Epeteys/Cave_Radio_PDB/README.md

\# Cave\_Radio\_PDB

Cave Radio Power Distribution Board. Consists of a battery input to USB-C/9V-jack outputs, as well as data passthrough from the USB-C to a USB-A connector.
