Epeteys/Cave_Radio_PDB/BOM/Cave_Radio_PDB.ods

Reference | Qty | Value | PN | DNP | Exclude from BOM | Exclude from Board | Footprint
C1,C2,C3,C13,C15,C16,C17 | 7 | 0.1uF | CC0402KRX5R9BB104 |  |  |  | Cave_Radio_PDB:C_0402_1005Metric
C4,C6,C7,C11,C12 | 5 | 10uF | GRM188R61A106ME69D |  |  |  | Cave_Radio_PDB:R_0603_1608Metric
C9,C10 | 2 | 1nF | CC0402KRX7R9BB102 |  |  |  | Cave_Radio_PDB:C_0402_1005Metric
C14,C18 | 2 | 33pF | CC0402FRNPO9BN330 |  |  |  | Cave_Radio_PDB:C_0402_1005Metric
C19,C20,C21,C22,C23,C24,C25,C26,C27,C28,C29,C30 | 12 | 22uF | C3225X5R1C226M250AA |  |  |  | Cave_Radio_PDB:CAP_C3225X5R1C226M250AA
J9 | 1 | USB4110GFA | USB4110GFA |  |  |  | Cave_Radio_PDB:GCT_USB4110GFA
L1,L2 | 2 | 6.8uH | SRP5050FA-6R8M |  |  |  | Cave_Radio_PDB:IND_SPR5050_BRN-M
R1,R2,R3,R4,R14,R27 | 6 | 10k | RC0402FR-0710KL |  |  |  | Cave_Radio_PDB:R_0402_1005Metric
R5,R6 | 2 | 2.2k | RC0402FR-072K2L |  |  |  | Cave_Radio_PDB:R_0402_1005Metric
R7,R8,R11,R13,R24,R25,R26 | 7 | 0 | RC0402JR-070RL |  |  |  | Cave_Radio_PDB:R_0402_1005Metric
R15,R20 | 2 | 100k | RC0402FR-07100KL |  |  |  | Cave_Radio_PDB:R_0402_1005Metric
R16 | 1 | 19.1k | RC0402FR-0719K1L |  |  |  | Cave_Radio_PDB:R_0402_1005Metric
R17,R22 | 2 | 1k | RC0402FR-071KL |  |  |  | Cave_Radio_PDB:R_0402_1005Metric
R18 | 1 | 39.2k | RC0402FR-0739K2L |  |  |  | Cave_Radio_PDB:R_0402_1005Metric
R19 | 1 | 25.5k | RC0402FR-0725K5L |  |  |  | Cave_Radio_PDB:R_0402_1005Metric
R21 | 1 | 9.76k | RC0402FR-079K76L |  |  |  | Cave_Radio_PDB:R_0402_1005Metric
U1 | 1 | TPS25751D | TPS25751DREFR |  |  |  | Cave_Radio_PDB:Texas_REF0038A_WQFN-38-2EP_6x4mm_P0.4
U2 | 1 | CAT24C256 | CAT24C256HU4IGT3 |  |  |  | Cave_Radio_PDB:UDFN8_2X3_ONS
U3 | 1 | TLV75533PDRV | TLV75533PDRV |  |  |  | Cave_Radio_PDB:WSON-6-1EP_2x2mm_P0.65mm_EP1x1.6mm_ThermalVias
U4 | 1 | TVS2200DRV | TVS2200DRV |  |  |  | Cave_Radio_PDB:WSON-6-1EP_2x2mm_P0.65mm_EP1x1.6mm_ThermalVias
U5 | 1 | TPD2E2U06DRL | TPD2E2U06DRL |  |  |  | Cave_Radio_PDB:SOT-553
U6,U7 | 2 | LMR51450FNDRR | LMR51450FNDRR |  |  |  | Cave_Radio_PDB:WSON-12-1EP_3x3mm_P0.5mm_EP1.5x2.5mm_ThermalVias
