Epeteys/Cave_Radio_PDB/Cave_Radio_3D/NSR0340HT1G.STEP

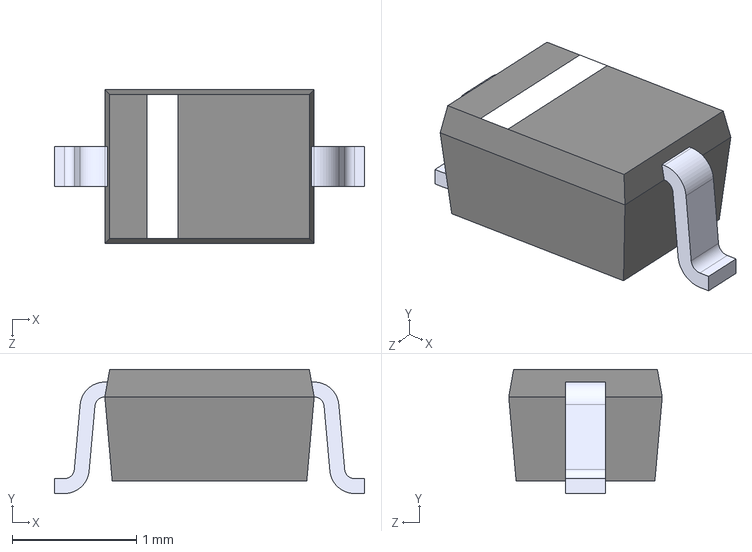
[picture p1: CAD file, 2026-04-06]
Cave_Radio_3D/NSR0340HT1G.STEP
2.50 x 1.00 x 1.24 mm
