Epeteys/Cave_Radio_PDB/Cave_Radio_3D/CAT24C256HU4IGT3--3DModel-STEP-56544.STEP

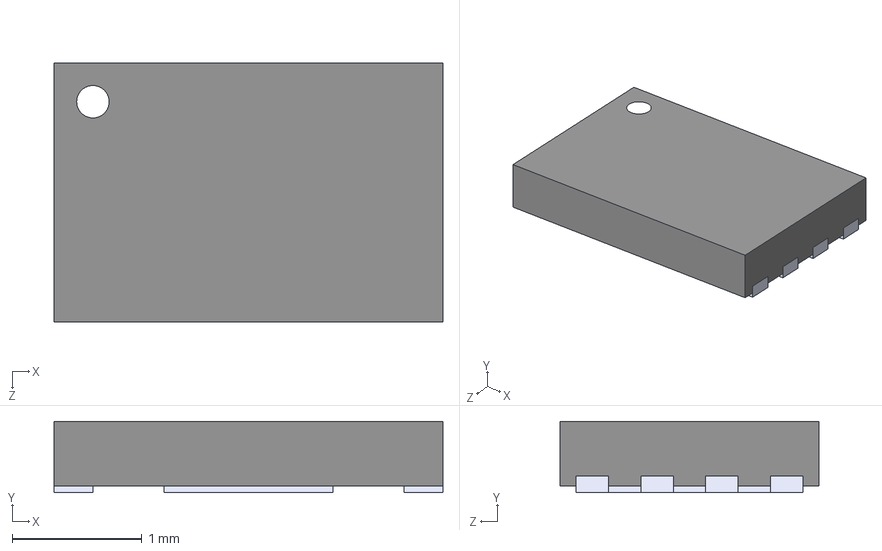
[picture p2: CAD file, 2026-04-06]
Cave_Radio_3D/CAT24C256HU4IGT3--3DModel-STEP-56544.STEP
3.00 x 0.55 x 2.00 mm
