Epeteys/Cave_Radio_PDB/Cave_Radio_3D/SRP5050FA-220M1.stp

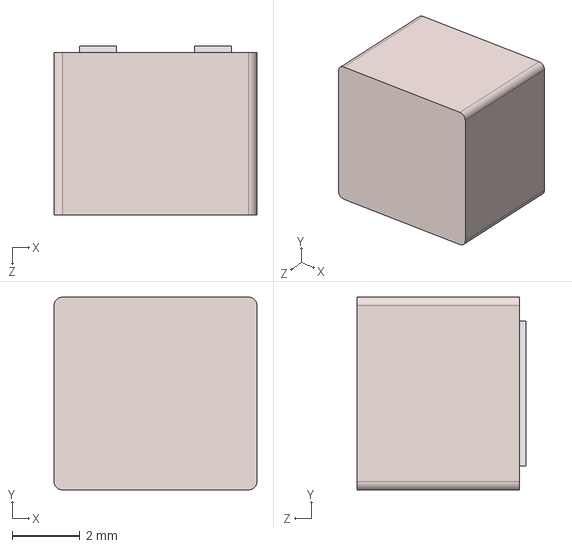
[picture p3: CAD file, 2026-04-06]
Cave_Radio_3D/SRP5050FA-220M1.stp
6.00 x 5.70 x 5.00 mm
