Epeteys/Cave_Radio_PDB/Cave_Radio_3D/LMR51450FNDRRR.STEP

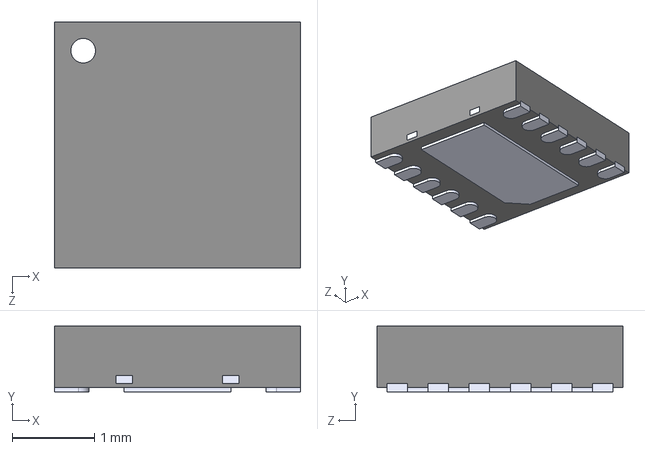
[picture p4: CAD file, 2026-04-06]
Cave_Radio_3D/LMR51450FNDRRR.STEP
3.00 x 0.8 x 3.00 mm
