Epeteys/Cave_Radio_PDB/Cave_Radio_3D/TPS25751DREFR--3DModel-STEP-56544.STEP

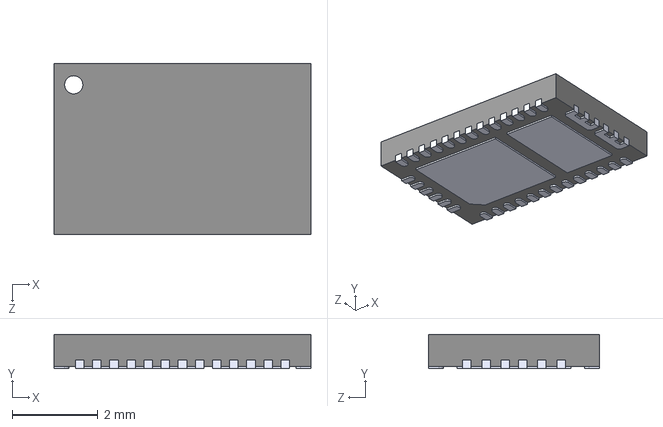
[picture p5: CAD file, 2026-04-06]
Cave_Radio_3D/TPS25751DREFR--3DModel-STEP-56544.STEP
6.00 x 0.8 x 4.00 mm
