Epeteys/Cave_Radio_PDB/Cave_Radio_3D/TPS259472LRPWR.STEP

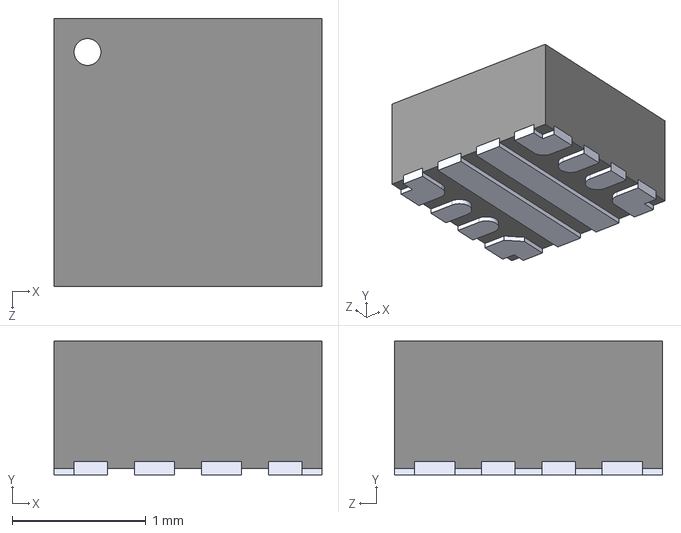
[picture p6: CAD file, 2026-04-06]
Cave_Radio_3D/TPS259472LRPWR.STEP
2.00 x 1.00 x 2.00 mm
