Epeteys/Cave_Radio_PDB/Cave_Radio_PDB.kicad_pcb

## KiCad design Cave_Radio_PDB.kicad_pcb (2026-04-13)

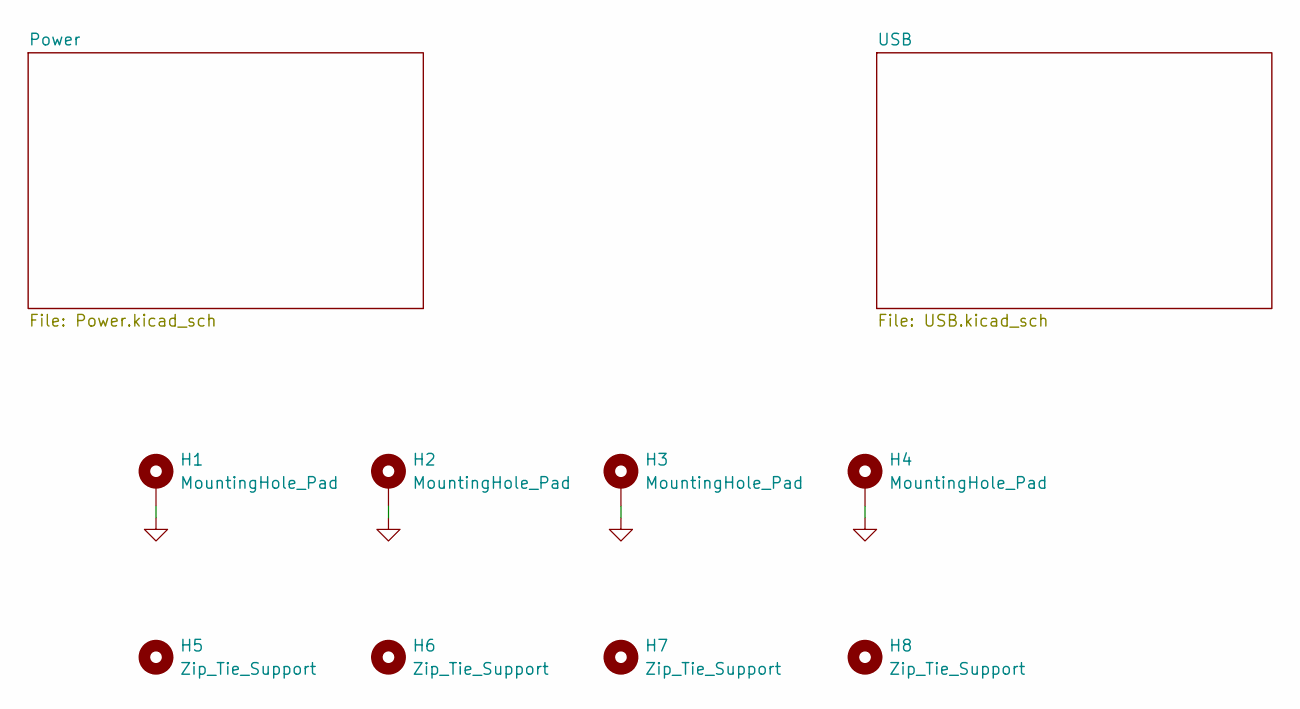
[picture p7: schematic Cave_Radio_PDB.kicad_sch, Cave Radio PDB]

Parts:
H1, H2, H3, H4: MountingHole_Pad; MountingHole_3.2mm_M3_DIN965_Pad_TopBottom
H5, H6, H7, H8: Zip_Tie_Support

Connections:
GND: H1.1, H2.1, H3.1, H4.1; also elsewhere on the board

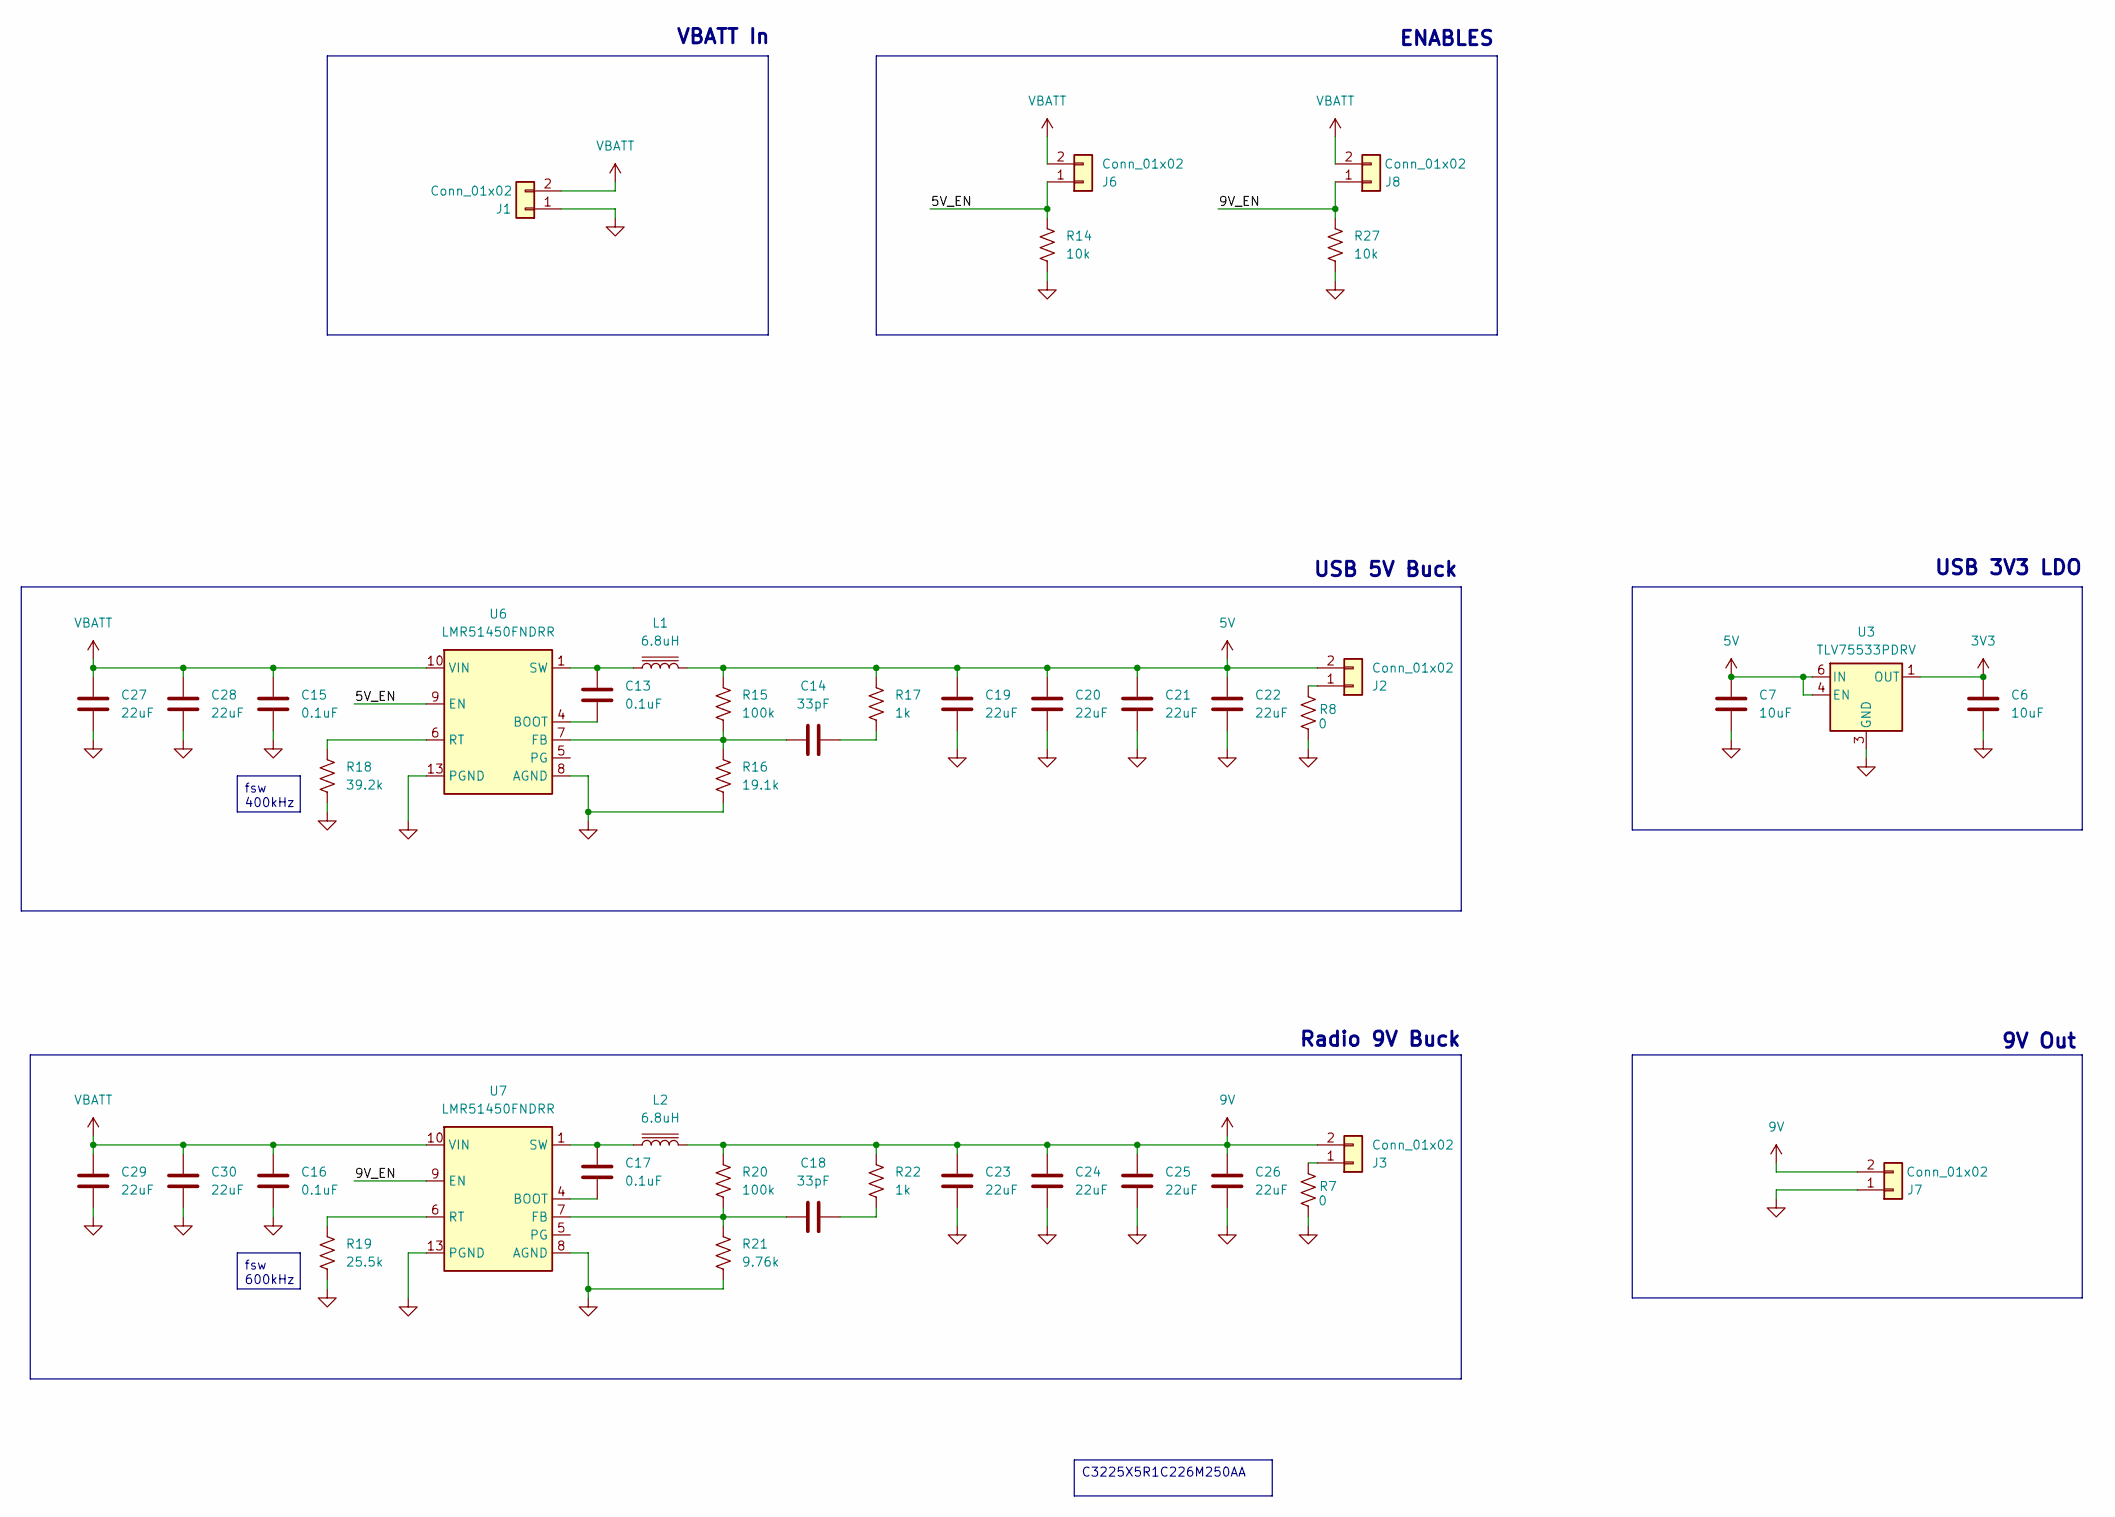
[picture p8: schematic Power.kicad_sch, Cave Radio PDB]

Parts:
C6, C7: 10uF; R_0603_1608Metric
C13, C15, C16, C17: 0.1uF; C_0402_1005Metric
C14, C18: 33pF; C_0402_1005Metric
C19, C20, C21, C22, C23, C24, C25, C26, C27, C28, C29, C30: 22uF; CAP_C3225X5R1C226M250AA
J1: Conn_01x02; CONN_102_PWR
J2, J3, J6, J7, J8: Conn_01x02; CONN_TSW-102-S_SAI
L1, L2: 6.8uH; IND_SPR5050_BRN-M
R7, R8: 0; R_0402_1005Metric
R14, R27: 10k; R_0402_1005Metric
R15, R20: 100k; R_0402_1005Metric
R16: 19.1k; R_0402_1005Metric
R17, R22: 1k; R_0402_1005Metric
R18: 39.2k; R_0402_1005Metric
R19: 25.5k; R_0402_1005Metric
R21: 9.76k; R_0402_1005Metric
U3: TLV75533PDRV; WSON-6-1EP_2x2mm_P0.65mm_EP1x1.6mm_ThermalVias
U6, U7: LMR51450FNDRR; WSON-12-1EP_3x3mm_P0.5mm_EP1.5x2.5mm_ThermalVias

Connections:
3V3: C6.1, U3.1 (OUT); also elsewhere on the board
5V: C7.1, C19.1, C20.1, C21.1, C22.1, J2.2, L1.2, R15.1, R17.1, U3.4 (EN), U3.6 (IN); also elsewhere on the board
9V: C23.1, C24.1, C25.1, C26.1, J3.2, J7.2, L2.2, R20.1, R22.1
/Power/5V_EN: J6.1, R14.1, U6.9 (EN)
/Power/9V_EN: J8.1, R27.1, U7.9 (EN)
GND: C6.2, C7.2, C15.2, C16.2, C19.2, C20.2, C21.2, C22.2, C23.2, C24.2, C25.2, C26.2, C27.2, C28.2, C29.2, C30.2, J1.1, J7.1, R7.1, R8.1, R14.2, R16.2, R18.2, R19.2, R21.2, R27.2, U3.3 (GND), U3.7 (GND), U6.8 (AGND), U6.13 (PGND), U7.8 (AGND), U7.13 (PGND); also elsewhere on the board
unnamed: C13.1, L1.1, U6.1 (SW), U6.2 (SW), U6.3 (SW)
unnamed: C14.2, R17.2
unnamed: C17.1, L2.1, U7.1 (SW), U7.2 (SW), U7.3 (SW)
unnamed: C18.2, R22.2
unnamed: J2.1, R8.2
unnamed: J3.1, R7.2
unnamed: C13.2, U6.4 (BOOT)
unnamed: C14.1, R15.2, R16.1, U6.7 (FB)
unnamed: R18.1, U6.6 (RT)
unnamed: C17.2, U7.4 (BOOT)
unnamed: C18.1, R20.2, R21.1, U7.7 (FB)
unnamed: R19.1, U7.6 (RT)
VBATT: C15.1, C16.1, C27.1, C28.1, C29.1, C30.1, J1.2, J6.2, J8.2, U6.10 (VIN), U6.11 (VIN), U6.12 (VIN), U7.10 (VIN), U7.11 (VIN), U7.12 (VIN)

Notes on the sheet:
USB 5V Buck
Radio 9V Buck
USB 3V3 LDO
ENABLES
VBATT In
9V Out
fsw 400kHz
fsw 600kHz
C3225X5R1C226M250AA

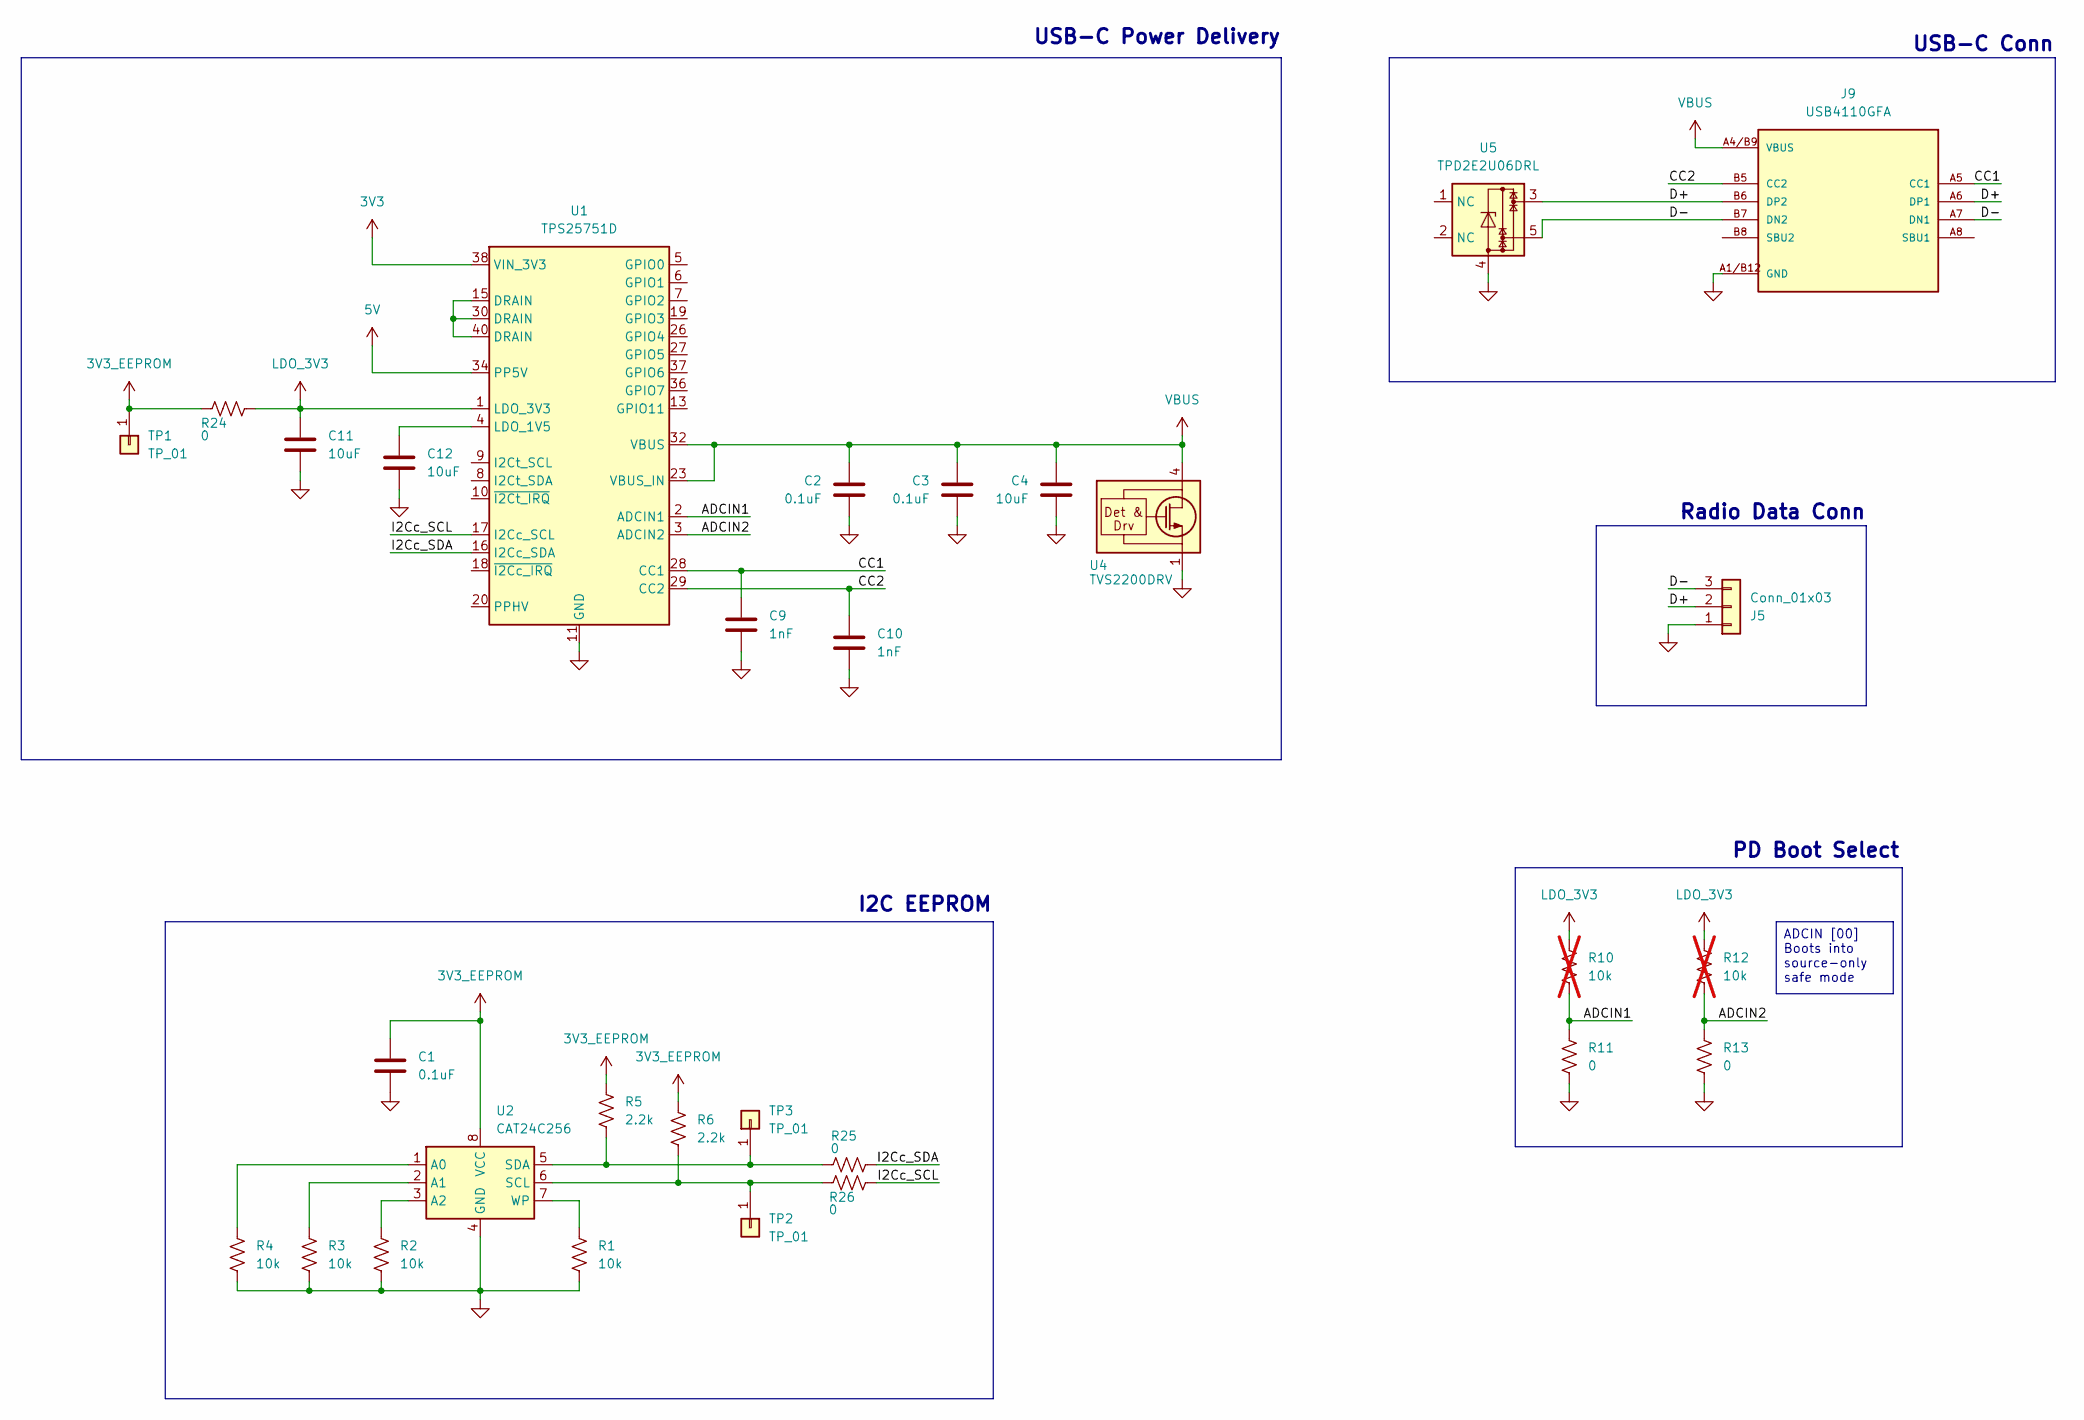
[picture p9: schematic USB.kicad_sch, Cave Radio PDB]

Parts:
C1, C2, C3: 0.1uF; C_0402_1005Metric
C4, C11, C12: 10uF; R_0603_1608Metric
C9, C10: 1nF; C_0402_1005Metric
J5: Conn_01x03; CONN_TSW-103-S_SAI
J9: USB4110GFA; GCT_USB4110GFA
R1, R2, R3, R4: 10k; R_0402_1005Metric
R5, R6: 2.2k; R_0402_1005Metric
R10, R12: 10k; R_0402_1005Metric; not fitted
R11, R13, R24, R25, R26: 0; R_0402_1005Metric
TP1, TP2, TP3: TP_01; CONN_TP
U1: TPS25751D; Texas_REF0038A_WQFN-38-2EP_6x4mm_P0.4
U2: CAT24C256; UDFN8_2X3_ONS
U4: TVS2200DRV; WSON-6-1EP_2x2mm_P0.65mm_EP1x1.6mm_ThermalVias
U5: TPD2E2U06DRL; SOT-553

Connections:
3V3: U1.38 (VIN_3V3); also elsewhere on the board
3V3_EEPROM: C1.1, R5.1, R6.1, R24.1, TP1.1, U2.8 (VCC)
5V: U1.34 (PP5V); also elsewhere on the board
/USB/ADCIN1: R10.2, R11.1, U1.2 (ADCIN1)
/USB/ADCIN2: R12.2, R13.1, U1.3 (ADCIN2)
/USB/CC1: C9.1, J9.A5 (CC1), U1.28 (CC1)
/USB/CC2: C10.1, J9.B5 (CC2), U1.29 (CC2)
/USB/D+: J5.2, J9.A6 (DP1), J9.B6 (DP2), U5.3
/USB/D-: J5.3, J9.A7 (DN1), J9.B7 (DN2), U5.5
/USB/I2Cc_SCL: R26.2, U1.17 (I2Cc_SCL)
/USB/I2Cc_SDA: R25.2, U1.16 (I2Cc_SDA)
GND: C1.2, C2.2, C3.2, C4.2, C9.2, C10.2, C11.2, C12.2, J5.1, J9.A1/B12 (GND), J9.B1/A12 (GND), J9.S1 (GND), J9.S2 (GND), J9.S3 (GND), J9.S4 (GND), R1.2, R2.2, R3.2, R4.2, R11.2, R13.2, U1.11 (GND), U1.12 (GND), U1.14 (GND), U1.31 (GND), U1.39 (GND), U2.4 (GND), U2.9 (PAD), U4.1 (GND), U4.2 (GND), U4.3 (GND), U4.7 (GND), U5.4; also elsewhere on the board
LDO_3V3: C11.1, R10.1, R12.1, R24.2, U1.1 (LDO_3V3)
unnamed: R6.2, R26.1, TP2.1, U2.6 (SCL)
unnamed: R5.2, R25.1, TP3.1, U2.5 (SDA)
unnamed: U1.15 (DRAIN), U1.30 (DRAIN), U1.40 (DRAIN)
unnamed: C12.1, U1.4 (LDO_1V5)
unnamed: R4.1, U2.1 (A0)
unnamed: R3.1, U2.2 (A1)
unnamed: R2.1, U2.3 (A2)
unnamed: R1.1, U2.7 (WP)
VBUS: C2.1, C3.1, C4.1, J9.A4/B9 (VBUS), J9.B4/A9 (VBUS), U1.23 (VBUS_IN), U1.32 (VBUS), U4.4 (IN), U4.5 (IN), U4.6 (IN)

Notes on the sheet:
USB-C Power Delivery
USB-C Conn
PD Boot Select
I2C EEPROM
Radio Data Conn
ADCIN [00] Boots into source-only safe mode

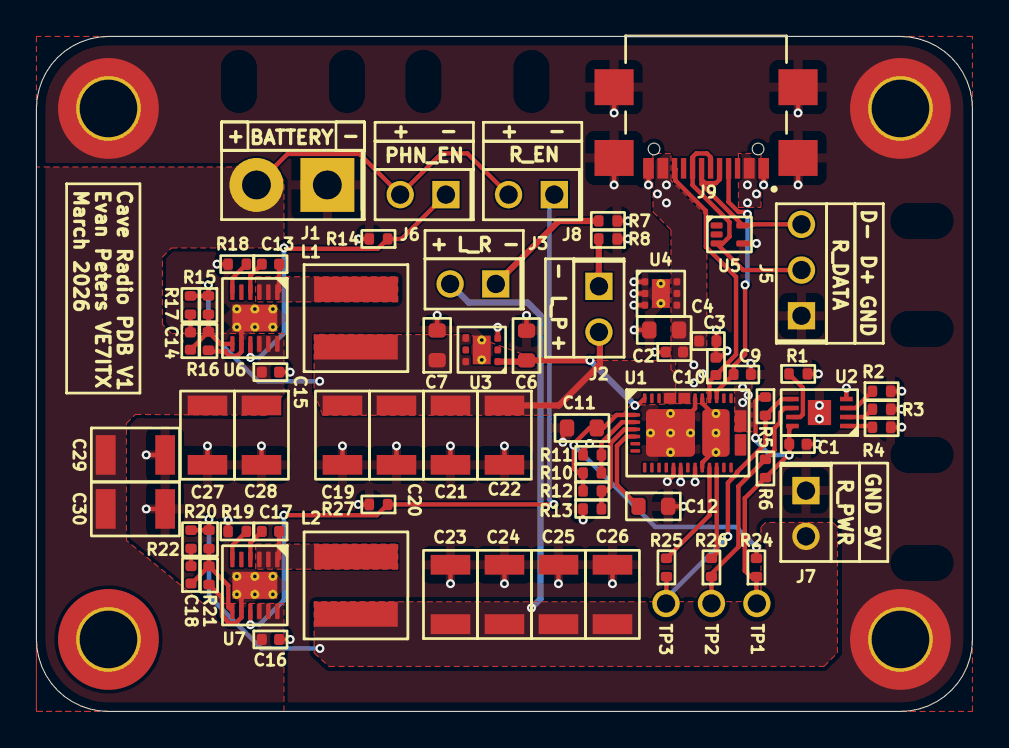
[picture p10: board Cave_Radio_PDB.kicad_pcb from above]

Board: 2 copper layers, 52.0 x 37.5 mm, 81 parts (0 on the bottom side), 38 nets.
