Epeteys/Cave_Radio_PDB/(commit log)

2026-03-21 add PD controller first draft
    [Cave_Radio_PDB.kicad_sch, Power.kicad_sch, USB.kicad_sch]
2026-03-22 add power supplies
    [Power.kicad_sch, USB.kicad_sch]
2026-03-23 start efuse and rough layout
    [Cave_Radio_PDB.kicad_pcb, Cave_Radio_PDB.kicad_sch, Power.kicad_sch, USB.kicad_sch]
2026-03-24 finish efuse schematic, update connectors
    [Power.kicad_sch, USB.kicad_sch]
2026-03-29 Update footprints
    [Cave_Radio_PDB.kicad_pcb, Power.kicad_sch, USB.kicad_sch]
2026-04-06 start layout
    [CAT24C256HU4IGT3--3DModel-STEP-56544.STEP, Cave_Radio_PDB.kicad_pcb, Cave_Radio_PDB.kicad_sch, LMR51450FNDRRR.STEP, NSR0340HT1G.STEP, Power.kicad_sch, SRP5050FA-220M1.stp, TPS25751DREFR--3DModel-STEP-56544.STEP]
2026-04-06 initial layout
    [Cave_Radio_PDB.kicad_pcb, Cave_Radio_PDB.kicad_sch, USB.kicad_sch]
2026-04-08 add via stitching
    [Cave_Radio_PDB-B_Cu.gbr, Cave_Radio_PDB-B_Mask.gbr, Cave_Radio_PDB-B_Paste.gbr, Cave_Radio_PDB-B_Silkscreen.gbr, Cave_Radio_PDB-Edge_Cuts.gbr, Cave_Radio_PDB-F_Cu.gbr, Cave_Radio_PDB-F_Mask.gbr, Cave_Radio_PDB-F_Paste.gbr]
2026-04-12 remove efuse, add led connectors
    [Cave_Radio_PDB-B_Cu.gbr, Cave_Radio_PDB-B_Mask.gbr, Cave_Radio_PDB-B_Paste.gbr, Cave_Radio_PDB-B_Silkscreen.gbr, Cave_Radio_PDB-Edge_Cuts.gbr, Cave_Radio_PDB-F_Cu.gbr, Cave_Radio_PDB-F_Mask.gbr, Cave_Radio_PDB-F_Paste.gbr]
2026-04-13 add bom
    [Cave_Radio_PDB-B_Cu.gbr, Cave_Radio_PDB-B_Mask.gbr, Cave_Radio_PDB-B_Paste.gbr, Cave_Radio_PDB-B_Silkscreen.gbr, Cave_Radio_PDB-Edge_Cuts.gbr, Cave_Radio_PDB-F_Cu.gbr, Cave_Radio_PDB-F_Mask.gbr, Cave_Radio_PDB-F_Paste.gbr]
